esden/openmulticopter/README

About
-----
openmulticopter is an effort to create a multicopter based on 100% Free
Software and Free Hardware.

Contact
-------
You can find more information about the project on http://openmulticopter.org.

If you have questions just subscribe to the openmulticopter mailinglist:
http://openmulticopter.org/cgi-bin/mailman/listinfo/openmulticopter

If you want to be notified about commits to the repositories subscribe to the
openmulticopter-commits mailinglist:
http://openmulticopter.org/cgi-bin/mailman/listinfo/openmulticopter-commits

We also have an IRC channel (#openmulticopter on freenode.net).

References
----------
This project is based on the awesome effort made in the paparazzi project
creating the booz platform.

Original software:
http://svn.savannah.gnu.org/viewvc/paparazzi3/trunk/sw/airborne/booz/?root=paparazzi
Original hardware:
http://svn.savannah.gnu.org/viewvc/paparazzi4/trunk/hw/booz/?root=paparazzi
