esden/openmulticopter/hardware/mini/v0.1/geda/README

-------------------------------------------------------------------------------
README
-------------------------------------------------------------------------------

This is an effort to implement the openmulticopter hardware descriptions
(schematics and PCB layouts) using the open-source tools gEDA/pcb.
