esden/openmulticopter/hardware/mini/v0.1/eagle/complete/Components.txt

Components from Distrelec (Distributor)

== Power Supply ==
Cout 100uF:	800715

4.7uF 	0805	823522
22uF	1210	823521
10uF	0805	823511
10uF	1206	823513
22uH    2220    351481

= Battery (Z-Diode) =
3.6V    SOT23   600733

= AVCC =
100uH   1210    490-4065-1-ND (Digikey)
22uF    SMC_B   812126

= AVDD =
100uH   0805    445-3617-1-ND (Digikey)
22uF    SMC_A   812085

== Gyros ==

1uF     0603    823495
1uF     SMC_A   812091
