esden/openmulticopter/documentation/mini/partlist/v0.1/BOM-omc.ods

Designator | Value | Footprint | Description | Comment | Digikey | Farnell | Distrelec | Qty
C1, C7..C18, C23..C25, C29, C32, C33 | 100nF | 0603 | Capacitor | X7R / 50VDC |  |  | 823499 | 19
C19, C20 | 22uF | 0805 | Capacitor | X5R / 10VDC | 587-1958-1-ND |  |  | 2
C2 | 330uF | E3.5-8 | Polarized Capacitor | 25VDC |  |  | 802584 | 1
C21 | 33uF | 3528/B | Polarized Capacitor | SMB / 10VDC |  |  | 812127 | 1
C22 | 100uF | E2-5 | Polarized Capacitor | 10VDC |  |  | 800463 | 1
C3..C6, C26..C28, C31 | 220nF | 0603 | Capacitor | Y5V / 50VDC |  |  | 823502 | 8
C30, C34 | 4.7uF | 0603 | Capacitor | X5R / 25VDC |  |  |  | 2
D1 | C3V6 | SOT23 | Zener-Diode | Zener-voltage: 3.6V | BZX84C3V6-FDICT-ND |  | 600733 | 1
D2 | S2G | SMB | Diode | Rectifier diode 1.5A/400V |  |  | 601629 | 1
D4 | 1N4004 | MELF-MLL41 | Diode | DO-213AB = MELF, 1A/400V |  |  | 601708 | 1
F1 |  | 1206 | Fuse | Super fast, FF, 1A |  |  | 281121 | 1
H0, H1 | red | 0603 | SMD LED | Uf = 2.1V, If = 20mA |  |  | 630699 | 2
H2, H3 | green | 0603 | SMD LED | Uf = 2.1V, If = 20mA |  |  | 630319 | 2
H4, H5 | yellow | 0603 | SMD LED | Uf = 2.1V, If = 20mA |  |  | 630698 | 2
IC1 | ADUM1250 | SO8 | ADUM1250 - Hot Swappable, Dual I2C Isolators | Supply-voltage: 3V..5.5V | ADUM1250ARZ-ND |  |  | 1
IC2 | SN65HVD230 | SO8 | 3.3V CAN Transceiver |  | 296-13123-5-ND |  |  | 1
IC3, IC4 | AD8544ARU | TSSOP14 | AD8544 - General Purpose CMOS Quad Rail- to-Rail Amplifier |  | AD8544ARUZ-ND | 1333257 |  | 2
IC5 | STM32F103RE | LQFP64 | High density STM32 – 512kB Flash, USB, CAN, 11 Timers, 3 ADCs, 13 communication interfaces |  | 497-9033-ND (256kB) / 497-6444-ND (512kB) |  |  | 1
L102 | 100uH | 1210 | Inductor | 100mA/3.5Ohm | 490-4065-1-ND |  |  | 1
L2 | 100uH | 0805 | Inductor | 30mA/3Ohm | 445-3617-1-ND |  |  | 1
Q1 | 8MHz | ASE_OSCILLATOR | Abracon ASE 3.3V CMOS Crystal Clock Oscillator | +/- 50ppm | 535-9558-1-ND |  |  | 1
R1, R3, R6, R9 | 22kΩ | 0603 | Resistor | 100mW/75V |  |  | 715620 | 4
R10, R14, R18, R25 | 43kΩ | 0603 | Resistor | 100mW/75V |  |  | 715627 | 4
R12, R13, R22, R34 | 15kΩ | 0603 | Resistor | 100mW/75V |  |  | 715616 | 4
R2, R4, R5, R7, R15, R16, R19 | 100Ω | 0603 | Resistor | 100mW/75V |  |  | 715564 | 9
R20, R36 | 10kΩ | 0603 | Resistor | 100mW/75V |  |  | 715612 | 2
R21, R26..R28, R31, R35, R39 | 120Ω | 0603 | Resistor | 100mW/75V |  |  | 715566 | 7
R23, R32 | 3.3kΩ | 0603 | Resistor | 100mW/75V |  |  | 715600 | 2
R8, R11, R17, R30, R37, R38 | 4.7kΩ | 0603 | Resistor | 100mW/75V |  |  | 715604 | 6
S1 |  | COPAL_CVS-01B | Copal CVS series – single dip switch | 100mA at 6VDC | 563-1192-1-ND |  |  | 1
SV1 | Extension | ML10L | Shrouded pin header 2x5, 90° |  | MHE10E-ND |  | 121424 | 1
SV2 |  | MA02-1 | Pin header 2 leads |  |  |  | 122830 | 1
SV3 | JTAG | ML10 | SMD pin header 2x5 | FTSH-105-01-L-DV-K-P mates with FFSD-05-S-06.00-01-N | S9012E-05-ND / FTSH-105-01-L-DV-K-ND |  |  | 1
T1 | BC817 | SOT23-BEC | NPN Transistor – small signal |  | BC817-25-TPMSCT-ND |  | 610372 | 1
U1, U3, U4 | MLX90609 | MLX90609-BREAKOUT | MLX Gyro | sparkfun (http://www.sparkfun.com/commerce/product_info.php?products_id=8372) |  |  |  | 3
U5 | MXR9500 | MXR9500-LCC16 | Memsic MXR9500 Tri Axis Accelerometer |  |  | 1365612 |  | 1
U6 | LM3940IMP | SOT223 | National Linear Regulator |  | LM3940IMP-3.3CT-ND |  | 648486 | 1
U7 | R-785.0-0.5 | R-78XX | Recom R78xx Switching Regulator |  | 945-1037-ND |  | 363569 | 1
U8 | HMC5843 | LPCC20-HMC5843 | Honeywell 3-Axis Digital Magnetometer |  | 342-1071-ND |  |  | 1
U9 | BMP085 | LCC8 | Digital Pressure Sensor |  | 828-1005-1-ND |  |  | 1
X1, X5, X6 |  | PB-53261-04 | SMD molex connector 4 pol |  | WM7622CT-ND |  |  | 3
X2, X3, X9 |  | PB-53261-03 | SMD molex connector 3 pol |  | WM7621CT-ND |  |  | 3
