esden/openmulticopter/(list of files, drawings)

Other design files:
hardware/centerplates/geda/centerplates.pcb
hardware/mini/v0.1/geda/omc.pcb
