esden/openmulticopter/(commit log)

2009-07-14 Initial commit of the omc board schematic.
    [omc-complete.sch]
2009-07-15 Added omc eagle library with stm32 in TQFP48,64 and 100 versions.
2009-07-15 Added serial and usb connector to the schematic.
    [omc-complete.sch]
2009-07-15 Replaced the STM32 in TQFP48 package with the TQFP64 version. The smaller one will have not enough pins for sure. (we may be forced to swith to the 100 pin version even)
    [omc-complete.sch]
2009-07-27 Moved the current schematic to the mini directory. (this will become the mini version of omc, as described in http://openmulticopter.org/wiki/Documentation/mini/v0.1)
    [omc-complete.sch]
2009-07-27 Removed USB, we will not need it in the mini version.
    [omc-complete.sch]
2009-07-27 Realigned everything to the 0.1" grid.
    [omc-complete.sch]
2009-07-27 Renamed the usart to PC-USART added DSL-USART
    [omc-complete.sch]
2009-07-27 Moved V_BAT line to PA5, added GYRO_[XYZ] and ACC_[XYZ] nets.
    [omc-complete.sch]
2009-07-27 Fixed a two typos in the footprints of the STM32.
    [omc-complete.sch]
2009-07-27 Added 4 I2C connectors for motor controllers. And termination resistors. A I2C driver still should be considered.
    [omc-complete.sch]
2009-07-29 Replaced i2c pin headers with molex connectors.
    [omc-complete.sch]
2009-07-30 Added CAN transceiver, I2C level shifter and solder jumpers for selecting between the two on motor controller connectors.
    [omc-complete.sch]
2009-07-31 Added accelerometer to the schematic.
    [omc-complete.sch]
2009-07-31 Fixed prefixes for ACC and Gyro parts.
2009-07-31 Added gyroscopes to the schematic.
    [omc-complete.sch]
2009-08-02 Replaced the 5V regulator with PTH08080 switching regulator.
    [omc-complete.sch]
2009-08-02 Moved all eagle PCB files to subdirs. (preparing for gEDA support)
    [omc-complete.sch]
2009-08-02 Bootstrapped gEDA pcb layout infrastructure.
    [gsch2pcb.cfg]
2009-08-02 Initial openmulticopter gEDA schematic with A1 titleblock.
    [omc.sch]
2009-08-02 Added options for color print output.
2009-08-02 Added CAN bus transceiver circuit.
    [omc.sch]
2009-08-02 Added fixed footprints.
    [omc.sch]
2009-08-02 Added bootstrap pcb file with desired settings.
    * Four layers
    * Board size: 50mm x 50mm
    * Grid size: 8mil
    * Signal wire size: 8mil
    * Power wire size: 16mil
    * Clearance: 8mil
    * Via hole size: 0.4mm
    * Via restring: 2mil
    [omc.pcb]
2009-08-02 Fixed grid size.
    [omc.pcb]
2009-08-02 Changed placement of supply symbols to fit norm rules. Made some regrouping and clean up as well.
    [omc-complete.sch]
2009-08-02 Added STM32F103Rx gEDA symbol.
2009-08-02 Added STM32 to the schematic.
    [omc.sch]
2009-08-02 Small fixes in STM32 symbol source file.
2009-08-02 Add ADXL335 cirtcuitry to the schematic.
    [omc.sch]
2009-08-03 Fix typos.
    [gsch2pcb.cfg]
2009-08-03 Added/fixed footprints.
    [omc.sch]
2009-08-03 Add circuitry for three MLX90609 components.
    [omc.sch]
2009-08-03 Add some more circuitry and netnames for the STM32.
    [omc.sch]
2009-08-04 Make STM32 cirtuits and others more compact, don't show footprints.
    [omc.sch]
2009-08-04 Added ADuM1250 and it's tiny friends to the schematic.
    [omc.sch]
2009-08-04 Added motor connectors.
    [omc.sch]
2009-08-13 Add empty 100mm x 100mm PCB for centerplates.
    [centerplates.pcb]
2009-08-13 Set line width to 1mm, via hole size to 3mm. Add 'outline' layer.
    [centerplates.pcb]
2009-08-13 Draw base outline in the outline layer, 10mm line thickness.
    [centerplates.pcb]
2009-08-13 Add four outer drill holes (vias).
    [centerplates.pcb]
2009-08-13 Add holes for IMU board and one big hole in the middle for cables.
    [centerplates.pcb]
2009-08-13 Sample holes for metal poles (29mm distance).
    [centerplates.pcb]
2009-08-13 Add openmulticopter silk screen text.
    [centerplates.pcb]
2009-08-13 Add openmulticopter footprint logo.
2009-08-13 Move logo into subdir so pcb finds it.
2009-08-13 Add Makefile for generating centerplates Gerber files.
2009-08-13 Add openmulticopter logo to the PCB.
    [centerplates.pcb]
2009-08-13 Add CC-BY-SA-3.0 text on silkscreen.
    [centerplates.pcb]
2009-08-13 Drop unused layers.
    [centerplates.pcb]
2009-08-14 Re-do centerplates outlines.
    [centerplates.pcb]
2009-08-20 Make holes/vias 3.2mm thick so they match M3 screws.
    [centerplates.pcb]
2009-08-20 Add pcb-photo-png target.
2009-09-08 Added led's.
    [omc.sch]
2009-09-08 Added JTAG connector.
    [omc.sch]
2009-09-09 Added PTH08080 based 5V and 3V3 voltage regulators.
    [omc.sch]
2009-09-11 Added ASE oszillator to schematic.
    [omc.sch]
2009-10-24 Added the IMU 6DOF Razor breakout board from Sparkfun to the eagle library.
2009-10-25 Added switching regulator LT1765 from linear technology to the eagle library.
2009-10-26 Removed unused components such as melexis gyros and power supplies.
    [omc-complete.sch]
2009-10-26 Started adding the ST Gyro LPR530AL. Symbol's done. Footprint's finished soon.
2009-10-27 Finished eagle symbol and footprint of LPR530AL (x-/y-axis gyro).
2009-10-28 Added LY530ALH footprint to eagle library.
2009-10-29 Changed name of x-/y-axis gyro from LPR530AL to LY510ALH and z-axis gyro from LY530ALH to LY510ALH and changed the pin directions of VREF to output.
2009-11-09 Added the switching regulator TPS54286 from TI to the eagle library. Could someone please verify the device / footprint?
2009-11-13 Cleaned up the eagle schematic. Removed old gyros as well as the old I2C level shifter. Replaced the eagle frame with a bigger one to make more room for drawing.
    [omc-complete.sch]
2009-11-26 Added inductor with footprint 2220 to the eagle library. Started schematic on power supply. Added a list of components with order number from Distrelec (Distributor).
    [omc-complete.sch]
2009-11-26 Did a small cleanup.
    [omc-complete.sch]
2009-11-27 Schematic on power supply. Added a Schottky diode to the eagle library.
    [omc-complete.sch]
2009-11-30 Did some cosmetic changes to the power supply part. The possibility of switching power off and on follows soon.
    [omc-complete.sch]
2009-12-03 Added MLX breakout-board (upright position) to eagle library.
2009-12-03 Started to work on the gyro part. Low pass filter needs to be added.
    [omc-complete.sch]
2009-12-04 Added EAGLE Cadsoft notice to the schematic: --For commercial use, a Commercial License of EAGLE needs to be purchased. --Please visit www.cadsoftusa.com for detailed information.
    [omc-complete.sch]
2009-12-05 Added customized frame to eagle library.
2009-12-05 Modified custom frame in eagle library and added some global attributes.
2009-12-05 Added a DIN A3 landscape frame as well.
2009-12-05 Resized DOCFILE for frames in eagle library. Added VCC and VDD symbol as well.
2009-12-05 Added 3 additional sheets in eagle schematic: block diagram, power supply, IMU Started the block diagram. Moved power supply, gyros and acc to corresponding sheets in the schematic. Replaced power su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
    [omc-complete.sch]
2009-12-06 Added a sheet: motors communication.
    [omc-complete.sch]
2009-12-06 Put AVDD and AGND to the analog power supply pins of STM32.
    [omc-complete.sch]
2009-12-06 Added components for LC filters (AVCC and AVDD).
2009-12-06 Had to re-add inductor footprint to eagle library?!?! Got lost somehow...
2009-12-06 Added LC (low pass) filter for AVCC and AVDD.
    [omc-complete.sch]
2009-12-07 Modified mlx breakout board in eagle library.
2009-12-07 Replaced z-axis gyro with breakout-board. This way we're flexible. ADXRS and MLX are insertable.
    [omc-complete.sch]
2009-12-07 Added 1210 footprint for inductor to eagle library.
2009-12-07 Changed capacitor value in components.txt. Modified low-filter.
    [omc-complete.sch]
2009-12-07 Changed component names from low-pass filter.
    [omc-complete.sch]
2009-12-08 Connected AGND and GND together over an 0Ohm resistor. Added MCU block to block diagram.
    [omc-complete.sch]
2009-12-09 Added the missing sheets to the overview sheed, added some symbolic connections on the overview sheet.
    [omc-complete.sch]
2009-12-09 Block diagram's nearly finished.
    [omc-complete.sch]
2009-12-10 Changed the layer of the connections on the first sheet to make the overview more readable.
    [omc-complete.sch]
2009-12-12 Added enable line for power supply in block diagram (mcu -> power supply)
    [omc-complete.sch]
2009-12-12 Added symbolic sheet entries for IMU and motor communication sheet in MCU sheet. Added a bus for connectors as well.
    [omc-complete.sch]
2009-12-13 Removed enable line from block diagram. Added GND to enable pins of voltage regulator
    [omc-complete.sch]
2009-12-14 Replaced the jtag adapter with the flossjtag connector. Removed the unnecessary pullup resistors.
    [omc-complete.sch]
2009-12-16 Added low-pass filter to gyro outputs. Voltage follower follows soon.
    [omc-complete.sch]
2009-12-19 Added power board schematic. Thanks to the developers of the booz project.
    [omc-powerBoard.sch, omc-powerboard.brd]
2009-12-21 Added voltage follower for gyros (with voltage divider 5V->3.3V) and acc.
    [omc-complete.sch]
2009-12-21 Switched component values of resistor. Wrong Value...
    [omc-complete.sch]
2009-12-21 Added voltage divider for battery measurment.
    [omc-complete.sch]
2010-01-03 Add ADUM1250 I2C isolators to EAGLE library.
    Please double check the footprints!
2010-01-03 Add I2C level shifter to EAGLE schematics
    [omc-complete.sch]
2010-01-03 Schematics finished. Read full commit msg for details.
    TO DEVELOPERS
    SCHEMATIC
    - Check the basic circuits for the STM32 (oscillator, AVDD / VDD, JTAG,
    etc).
    - Check wiring of components (False connected ICs, etc.)
    - Check all connections (data as well as power supplies). Are the net
    labels correct?
    - Did we forget something?
    LIBRARY (EAGLE)
    - Check the footprints off all used componets.
    - Size of footprints, pads, etc.
    - Pin configuration
    - Consistent with datasheet?
    It would be great if we could eliminate errors early. Better now than with a
    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
    [omc-complete.sch]
2010-01-08 Simplify gyroscope RC low-pass filter circuit.
    In order to minimize the number of components we recalculated the
    voltage divider to have an output impedance of approximately 15kOhm.
    This composes a 50 Hz low-pass filter in conjunction with a 220nF
    capacitor at the output of the voltage divider.
    [omc-complete.sch]
2010-01-08 Add decoupling capacitors to op-amp supply pins.
    [omc-complete.sch]
2010-01-09 Replaced some parts with pretty-eagle-lib versions.
    All 0603 resistors, leds, caps and polcaps.
    All picoblade molex connectors.
    You can find the libraries under github.com/esden/pretty-eagle-lib
    [omc-complete.sch]
2010-01-10 Add Memsic MXR9500 accelerometer to eagle library.
    Eagle footprint and symbol for the MXR9500 acceleration sensor.
2010-01-10 Replace ADXL335 with MXR9500.
    This commit includes a small change in the omc eagle library to make
    replacing the ADXL335 with the MXR9500 easier. Basically I've swapped
    the X,Y,Z pins and placed them closer together.
    Changes in the schematics include replacing the accelerometer and
    removing all traces of the self test pin (MXR9500 doesn't have this kind
    of functionality).
    [omc-complete.sch]
2010-01-10 Updated Authors docfield.
    I have added myself (Patrick) to the authors list. I changed a few things
    recently, helped out with tips in the past and I am planning to work on
    the layout in the near future. So I hope it's justified. ;-)
    [omc-complete.sch]
2010-01-10 Add RC low-pass filter for MXR9500 accelerometer.
    The ADXL335 had its outputs trimmed to an impedance of 32kOhm. Adding
    capacitors to the output resulted in a first-order low-pass RC filter.
    When I replaced the ADXL335 with the MXR9500 I forgot to add resistors
    to the low-impedance output pins of the sensor.
    I changed the MXR9500 symbol in our OMC eagle library to make the
    schematics look a bit nicer. There's a bit more distance between the
    sensor output pins now.
    [omc-complete.sch]
2010-01-10 Change accelerometer RC filter capacitor values.
    The low-pass filter is configured to a cut-off frequency of 50Hz. The
    value of the resitor and capacitor is 15kOhm and 220nF, resp.
    [omc-complete.sch]
2010-01-10 Change decoupling capacitor values of op-amps.
    Correcting a simple copy&paste error. The decoupling capacitor values
    should be 100nF each.
    [omc-complete.sch]
2010-01-14 Add missing servo connectors and fix supply pin at JTAG connector.
    [omc-complete.sch]
2010-01-30 Add AD8544 quad rail-to-rail op-amp to library.
    The AD8544 is a low-power rail-to-rail op-amp working from 2.7V to 5.5V
    single supply.
2010-01-30 Replace OPA4350 (SO14) with AD8544 (TSSOP14).
    The buffer op-amps in the sensor circuitry have been replaced by the
    AD8544, which suits our requirements better. It is optimized for supply
    voltages between 2.7V and 5.5V, features rail-to-rail input and output,
    is unity gain stable, available in a space-saving TSSOP14 package and to
    make things even better quite low-cost.
    [omc-complete.sch]
2010-02-01 Remove three motor connectors to save space.
    In order to place all the parts on a 50x50 mm2 board trade-offs must be
    made. Most people join the bus lines coming from the motors at one point
    and make a single connection to the control board. Therefore we do not
    need need four connectors on the board. A single one will be sufficient.
    [omc-complete.sch]
2010-02-01 Remove 1uF capacitors at the gyroscope supply pins.
    There are already decoupling capacitors on the gyroscope breakout
    boards.
    [omc-complete.sch]
2010-02-01 Replace SMD battery pads with through-hole-pads.
    SMD pads are susceptible to mechanical tension. Sometimes you literally
    pull them off the board. The battery wires should therefore be plugged
    in through-hole-pads before soldering them on the board.
    [omc-complete.sch]
2010-02-01 Add SN65HVD230 CAN driver to lib and schematics.
    TI's SN65HVD230 is pin-compatible with Microchip's MCP2551 CAN bus
    driver. In contrast to the MCP2551, it operates from 3.3V.
    This commit adds the device to the OMC Eagle library and conducts the
    necessary changes to replace the MCP2551 in the OMCmini schematics. All
    resistors at the output of the driver have been removed, except for the
    120 Ohm termination resistor.
    Additionally the Rs pin has been connected to the STM32, which will allow
    switching between normal operation and the listen-only mode, where the
    transmitter stage is disconnected from the bus lines. This allows
    recovering from certain error conditions.
    [omc-complete.sch]
2010-02-03 Add Recom R78xx switching regulator to library.
    The R78xx is pin-compatible with the popular LM7805 linear regulator and
    capable of providing up to 1A without need for an additional heatsink.
2010-02-03 Add LM3940 linear voltage regulator.
    National's LM3940 is a linear voltage regulator optimized for 5V to 3.3V
    conversion capable of supplying up to 1A output current.
    I added all available package variants: TO220, TO263, SOT223.
    I also did some cleanup in the OMC library: removed duplicate package,
    changed package descriptions.
2010-02-04 Create archive lib. Add polyfuse and TVS diode.
    I split up our eagle library. omc.lbr contains all the parts that are
    currently being used in our schematics. omc-archive.lbr contains parts
    that have been added to the library but didn't make it in our final
    schematics.
    I added a Bourns MF-SM series polyfuse and a TVS diode in SMB package.
    This will be part of our overvoltage/overcurrent protection.
2010-02-04 Add 1N400x diode in DO-213AB (MELF) package.
2010-02-04 Redesign power supply section.
    Creating our own switching regulator with the TPS5286 is almost
    impossible due to the space constraints we have.
    The new approach uses a Recom R785.0-0.5 switching regulator which
    includes all the necessary parts inside a small package. A LM3940 linear
    regulator is used for the 5V -> 3.3V conversion.
    A combination of TVS diode and polyfuse protects the board from inverse
    polarity, overvoltage and overcurrent conditions.
    [omc-complete.sch]
2010-02-04 Replace polyfuse with non-resettable SMD1206 fuse.
2010-02-04 Add SMB package to diode. Remove TVS diode.
    Renamed the 1N4004 to a more general "diode" device and added the SMB
    package variant. Removed the transil diode from the library.
2010-02-04 Replace polyfuse and TVS diode in schematics.
    The polyfuse has been replaced with a non-resettable 1206 SMD fuse.
    The TVS diode has been replaced with a SMB diode connected in series
    with the battery supply line.
    [omc-complete.sch]
2010-02-05 Place fuse after 330uF capacitor.
    When connecting the board to the battery a short but significant
    current peak will occur. This peak is caused by the large input
    capacitor which gets charged quickly. In order not to trip the fuse I
    relocated it after the capacitor.
    [omc-complete.sch]
2010-02-05 Remove two servo connectors. General cleanup.
    [omc-complete.sch]
2010-02-05 Relocate signals to other STM32 pins. Add PPM.
    I relocated a few signals to separate the analog signals from digital
    I/O lines like SPI as good as possible.
    I added a PPM signal, connected it to the Timer3 external counter pin on
    one end and to the DSL connector on the other.
    Added jumpers to DSL and PC USART to choose between VCC and VDD.
    [omc-complete.sch]
2010-02-06 Redesign of the MCU pin assignment.
    Analog signals are now subsumed in their own bus. I have tried to
    connect them to the MCU in such a way that the analog signal will all be
    in a single corner of the TQFP package instead of distributed across all
    four sides.
    The PPM input is now connected to PA8 (pin 41) where the capture channel
    1 of Timer1 is placed.
    I added a jumper to Boot0 which allows the user to choose between normal
    startup from Flash and startup from system memory. This should enable
    the bootloader support on USART1.
    Last but not least, a lot of cleanup in the MCU section has been done.
    [omc-complete.sch]
2010-02-06 Add op-amp buffer to battery measurement.
    [omc-complete.sch]
2010-02-06 Cosmetics on sheet 3.
    [omc-complete.sch]
2010-02-06 Add SPI-CS[1..3] and LED-[4..5].
    [omc-complete.sch]
2010-02-06 Add Extension-Board connector.
    Connector is a 2x5 pin header in 2.54mm grid. Might be changed to
    something smaller if it takes away too much space in the layout.
    [omc-complete.sch]
2010-02-06 Add transistor and connector for buzzer.
    [omc-complete.sch]
2010-02-07 Modify block diagram.
    Removed supply lines from diagram. Not really necessary.
    Added battery measurement line instead.
    Changed gyro net names in diagram.
    Corrected number of servo connectors.
    Added PPM connector in diagram.
    [omc-complete.sch]
2010-02-07 Replace jumpers and ASE oscillator in schematics.
    The SMD jumpers and the ASE oscillator came from the open-bldc lib. I
    think it's better not to mix the parts from both eagle libraries. If
    someone wants to work on the OMC (or open-bldc, resp.) schematics/
    layouts he expects to find all the parts he needs in the corresponding
    library.
    In a further step we will merge the most important parts that both
    projects share in the pretty-eagle-lib library. As an intermediate step
    I copied some parts from the open-bldc to the OMC library, though.
    [omc-complete.sch]
2010-02-07 Change PC/DSL USART voltage jumpers to SMD.
    [omc-complete.sch]
2010-02-07 Add Copal CVS series DIP switch (2 terminals).
2010-02-07 Replace bootloader jumper with Copal switch.
    Update Copal DIP switch description in library.
    [omc-complete.sch]
2010-02-07 Add 2-lead pin header with round shape to library.
2010-02-07 Replace buzzer connector with pin header.
    Due to a lack of 2-lead pin headers in the official eagle libraries I
    initially misused a jumper as a connector for the buzzer. I've now
    replaced it with a better fitting pin header from our omc lib.
    [omc-complete.sch]
2010-02-08 Remove CS3 line. Add VCC to Ext.Board connector.
    [omc-complete.sch]
2010-02-08 Add pcb-cart DRC-file.
2010-02-08 Replaced SO8 footprint with pel ref package.
2010-02-08 Updated most parts to current pretty-eagle-libs versions.
    Needs a peer review if no mistakes were made.
    Replaced parts:
    0603 resistors, capacitors
    0805 inductor
    SO8 footprints
    1206 fuse
    1210 inductor
    3528 diode, tantal
    Updated molex connectors
    [omc-complete.sch]
2010-02-08 Correct MXR9500 and Copal-switch silkscreen.
2010-02-09 Replace MELF diode with PEL version.
    [omc-complete.sch]
2010-02-09 Update Copal switch with new omc lib version.
    [omc-complete.sch]
2010-02-09 Moved diode, fuse and inductor to omc-archive.lbr.
    Those devices are now part of pretty-eagle-lib and therefore do not need
    to be included in the omc lib. As with all outdated or unused devices, I
    moved them into omc-archive in case someone should ever need them again.
2010-02-16 Add EAGLE project file to omc mini.
    The schematics weren't changed. Only activated the grid
    and saved the settings for the EAGLE project file.
    [omc-complete.sch]
2010-02-16 Cleanup in schematics.
    [omc-complete.sch]
2010-02-17 Add JTAG SMD connector male unshrouded header to omc.lbr
2010-02-17 Correct SMD 1.27mm header tPlace and package name.
2010-02-17 Add new ARM standard 10-pin debug connector.
    [omc-complete.sch]
2010-02-17 Correct some net names and add extra LED
    - Corrected net names of MISO, MOSI line to extension board connector.
    - Corrected a net name of an I2C line to the level shifter.
    - Added missing pull-ups on I2C for extension board.
    - Deleted not needed TRST line and added an additional LED (LED0).
    [omc-complete.sch]
2010-02-17 Some cleanup on sheet #4
    [omc-complete.sch]
2010-02-17 Add GND-AGND connection magic to omc.lbr.
2010-02-17 Add GND-AGND connection to OMC mini schematics.
    [omc-complete.sch]
2010-02-17 Add LCC8 footprint to omc.lbr.
2010-02-18 Add BMP085 (preassure sensor) to eagle library.
2010-02-18 Clean up and add sheet #6 (sensors)
    [omc-complete.sch]
2010-02-18 Copy and improve HMC5843 device from Sparkfun lib.
2010-02-18 Update block diagram
    [omc-complete.sch]
2010-02-18 Add HMC5843 magnetometer and BMP085 baro.
    [omc-complete.sch]
2010-02-18 Add block capacitor to compass
    [omc-complete.sch]
2010-02-18 Change omc.lbr -> 25mil/16%
    [omc-complete.sch]
2010-02-18 Create PCB
    [omc-complete.brd]
2010-02-19 Place 50x50 frame and place holes
    [omc-complete.brd]
2010-02-19 Add two more variants for omc logo (silkscreen)
2010-02-19 Start centerplate in EAGLE. Add holes.
    [centerplates.brd]
2010-02-19 Add logo and url. Finish frame.
    [centerplates.brd]
2010-02-19 Sorted components into placement- groups.
    [omc-complete.brd]
2010-02-19 Change some designators resp. Names of ICs according to IEC norm.
    [omc-complete.brd, omc-complete.sch]
2010-02-19 Add board outline to MLX90609 breakout package.
2010-02-19 Update MLX breakout boards in pcb due to docu layer changes.
    [omc-complete.brd, omc-complete.sch]
2010-02-20 Place gyros and define analog and power supply sections
    [omc-complete.brd]
2010-02-20 Roughly distribute power supply components.
    [omc-complete.brd]
2010-02-20 Replace battery input section
    [omc-complete.brd]
2010-02-20 Finish placing power supply section
    [omc-complete.brd]
2010-02-20 Place gyro parts
    [omc-complete.brd]
2010-02-20 Place voltage divider for battery
    [omc-complete.brd]
2010-02-20 Place ACC
    [omc-complete.brd]
2010-02-20 Replace ACC
    [omc-complete.brd]
2010-02-20 Start placement of STM32
    [omc-complete.brd]
2010-02-20 Place bootloader switch and oscillator
    [omc-complete.brd]
2010-02-20 Place servo connectors
    [omc-complete.brd]
2010-02-20 Place buzzer.
    [omc-complete.brd]
2010-02-20 Place PC UART connector
    [omc-complete.brd]
2010-02-20 Make more room for gyros
    [omc-complete.brd]
2010-02-20 Place all UART connectors. Have to move STM for JTAG.
    Maybe place STM in 45 degree angle and move little to the left.
    Place JTAG more to the left to make room for BLDC connector
    [omc-complete.brd]
2010-02-21 Place I2C level shifter
    [omc-complete.brd]
2010-02-21 Place CAN chip
    [omc-complete.brd]
2010-02-21 Replace buzzer
    [omc-complete.brd]
2010-02-21 Place Baro and Magneto
    [omc-complete.brd]
2010-02-21 Place JTAG
    [omc-complete.brd]
2010-02-21 Place LEDs. Placing finished. Ready to start routing.
    [omc-complete.brd]
2010-02-21 Some cleanup. Ready for routing now.
    [omc-complete.brd]
2010-02-21 Correct some components overlapping
    [omc-complete.brd]
2010-02-22 Add missing 4.7uF C for STM32 (Pin 12, 13).
    [omc-complete.brd, omc-complete.sch]
2010-02-22 Start routing. Power supply and some small data lines.
    [omc-complete.brd]
2010-02-22 Some routing
    [omc-complete.brd]
2010-02-23 Try to route out the pins from the STM
    [omc-complete.brd]
2010-02-23 Change min drill size to 0.4mm and restring to 0.1mm
    Changed DRC file accordingly
    [omc-complete.brd]
2010-02-23 Route "ext" and JTAG connectors.
    [omc-complete.brd]
2010-02-23 Route most connectors
    [omc-complete.brd]
2010-02-23 A lot of routing
    [omc-complete.brd]
2010-02-24 Move some vias for better routing conditions
    [omc-complete.brd]
2010-02-24 Route ADC lines of ACC to STM
    [omc-complete.brd]
2010-02-24 Start route servo pwm lines
    [omc-complete.brd]
2010-02-24 Finish route servo lines
    [omc-complete.brd]
2010-02-24 "Finish" routing of digital section. Switch to analog section now
    [omc-complete.brd]
2010-02-24 Start routing gyros
    [omc-complete.brd]
2010-02-24 Finish gyros. Starting baro
    [omc-complete.brd]
2010-02-24 Finish signal routing. Start power supply
    [omc-complete.brd]
2010-02-24 Start with power supply routing. Create GND planes
    [omc-complete.brd, omc-complete.sch]
2010-02-25 51 Airwires left. Start connecting positive power supply.
    [omc-complete.brd]
2010-02-25 Some power supply routing
    [omc-complete.brd]
2010-02-25 Routing finished. Start cosmetic fixes.
    [omc-complete.brd]
2010-02-25 Correct DRC errors
    [omc-complete.brd]
2010-02-25 A lot of cosmetic fixes.
    Changed power supply lines (to ICs, etc) width to 16mil and 24mil
    [omc-complete.brd]
2010-02-25 Add pcbcart drc-file for EAGLE
2010-02-25 Fix issue in board dimension
    [omc-complete.brd]
2010-02-26 Finish place component names (silkscreen).
    Board ready for check and ordering.
    [omc-complete.brd, omc-complete.sch]
2010-02-26 Add logo and copyright. Some cleanup.
    Changed names of LEDs from LED0..5 to H0...5 to save some space.
    [omc-complete.brd, omc-complete.sch]
2010-02-26 Some cosmetic fixes
    [omc-complete.brd, omc-complete.sch]
2010-02-26 More cosmetic fixes
    [omc-complete.brd, omc-complete.sch]
2010-02-26 Add teardrops
    [omc-complete.brd]
2010-02-26 Add teardrops only to wires smaller than 16mil
    [omc-complete.brd]
2010-02-26 Remove bad file
    [omc-complete.brd]
2010-02-26 Clean up
    [omc-complete.brd]
2010-02-27 Change layer of a single GND wire
    [omc-complete.brd]
2010-02-27 Change line width from 16mil to 24mil of a GND wire.
    [omc-complete.brd]
2010-02-27 Make separate brd file for teardrops.
    [omc-complete-teardrops.brd, omc-complete.brd]
2010-02-27 Some cosmetic fixes in tname placements
    [omc-complete-teardrops.brd]
2010-02-28 Move geda files to geda folder
    [centerplates.pcb]
2010-02-28 Add 5 molex connectors for motor-bus distribution
    [centerplates.brd, centerplates.sch]
2010-02-28 Fix drc errors
    [centerplates.brd]
2010-02-28 Move connectors
    [centerplates.brd]
2010-02-28 Change design issue
    [centerplates.brd]
2010-03-07 Replaced parts with pretty-eagle-libs versions.
    [omc-powerBoard.sch, omc-powerboard.brd]
2010-03-07 Added version number, copyright, license to the front side of the board.
    [omc-complete.brd]
2010-03-07 Updated omc teardrops version.
    [omc-complete-teardrops.brd]
2010-03-07 Added gerber file generation system.
    [layout.cfg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]
2010-04-03 Start BOM for omc mini. Needs formatting.
2010-04-15 Continue work on partlist
    Can't get landscape mode to work properly. Switch to openoffice
2010-04-27 Start partlist with openoffice
    [BOM-omc.ods]
2010-04-27 Continue partlist. Add some distributors
    [BOM-omc.ods]
2010-04-27 Added digikey part numbers for a bunch of parts.
    [BOM-omc.ods]
2010-09-01 Finish partlist
    [BOM-omc.ods]
2010-09-07 Update partlist
    [BOM-omc.ods]
2010-09-10 Fix typo
    [BOM-omc.ods, omc-complete.brd, omc-complete.sch]
2010-09-11 Remove Distrelec number for C34. Wrong part.
    [BOM-omc.ods]
